jd0i0i/VORTICE/CAD/PLANOS/LAMINA1_alzado.png

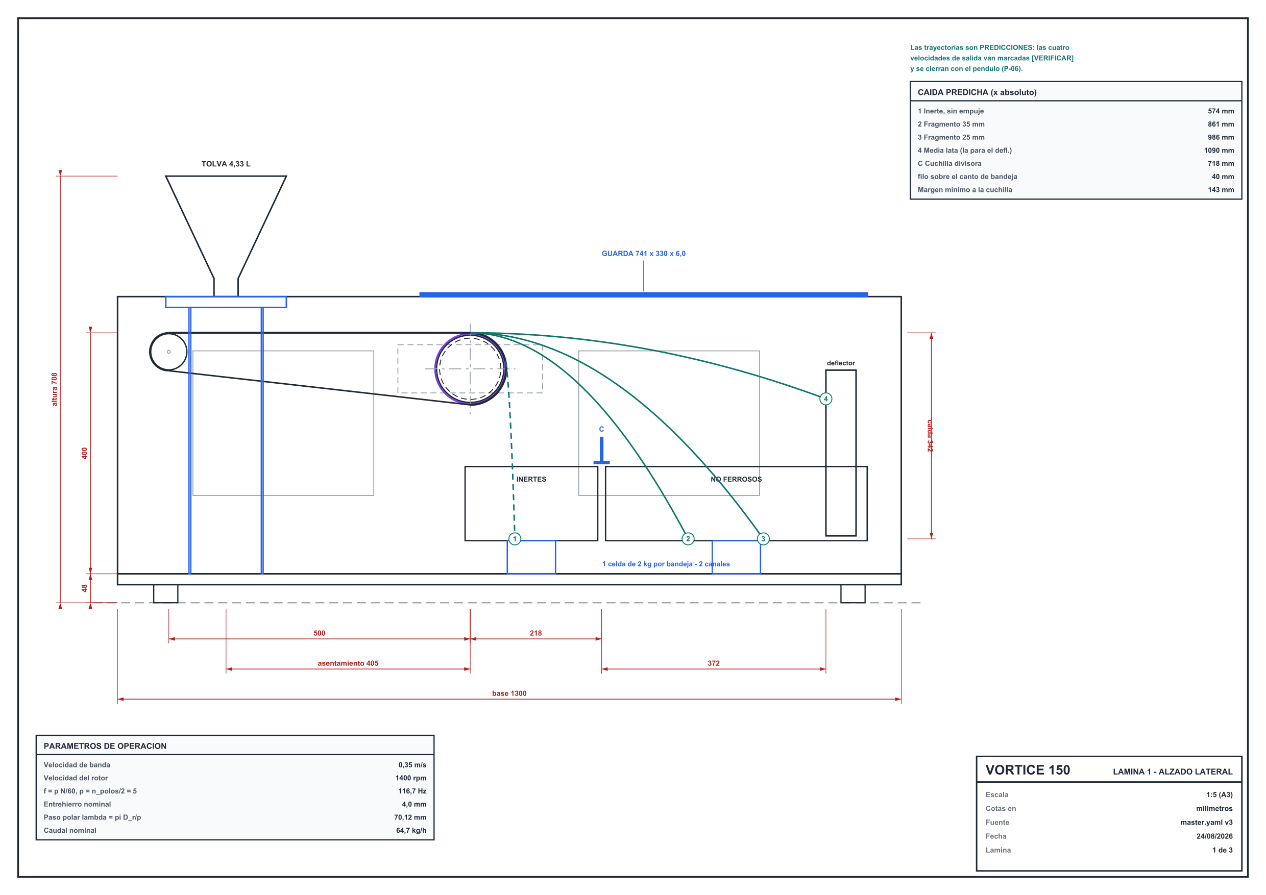
CAD/PLANOS/LAMINA1_alzado.png
