jd0i0i/VORTICE/CAD/PLANOS/LAMINA2_planta.png

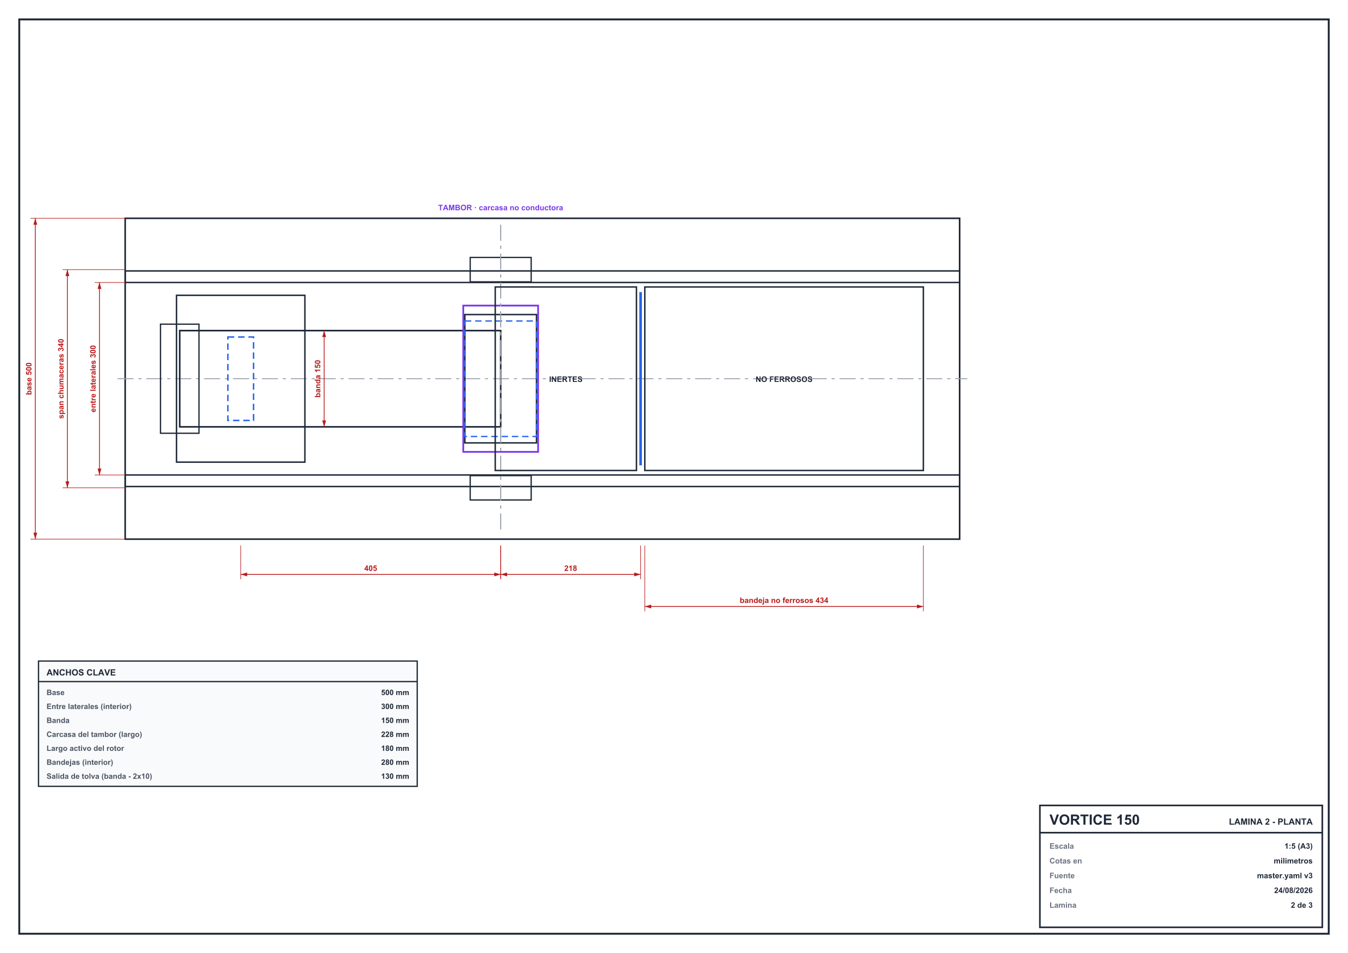
CAD/PLANOS/LAMINA2_planta.png
