jd0i0i/VORTICE/CAD/PLANOS/LAMINA3_rotor.png

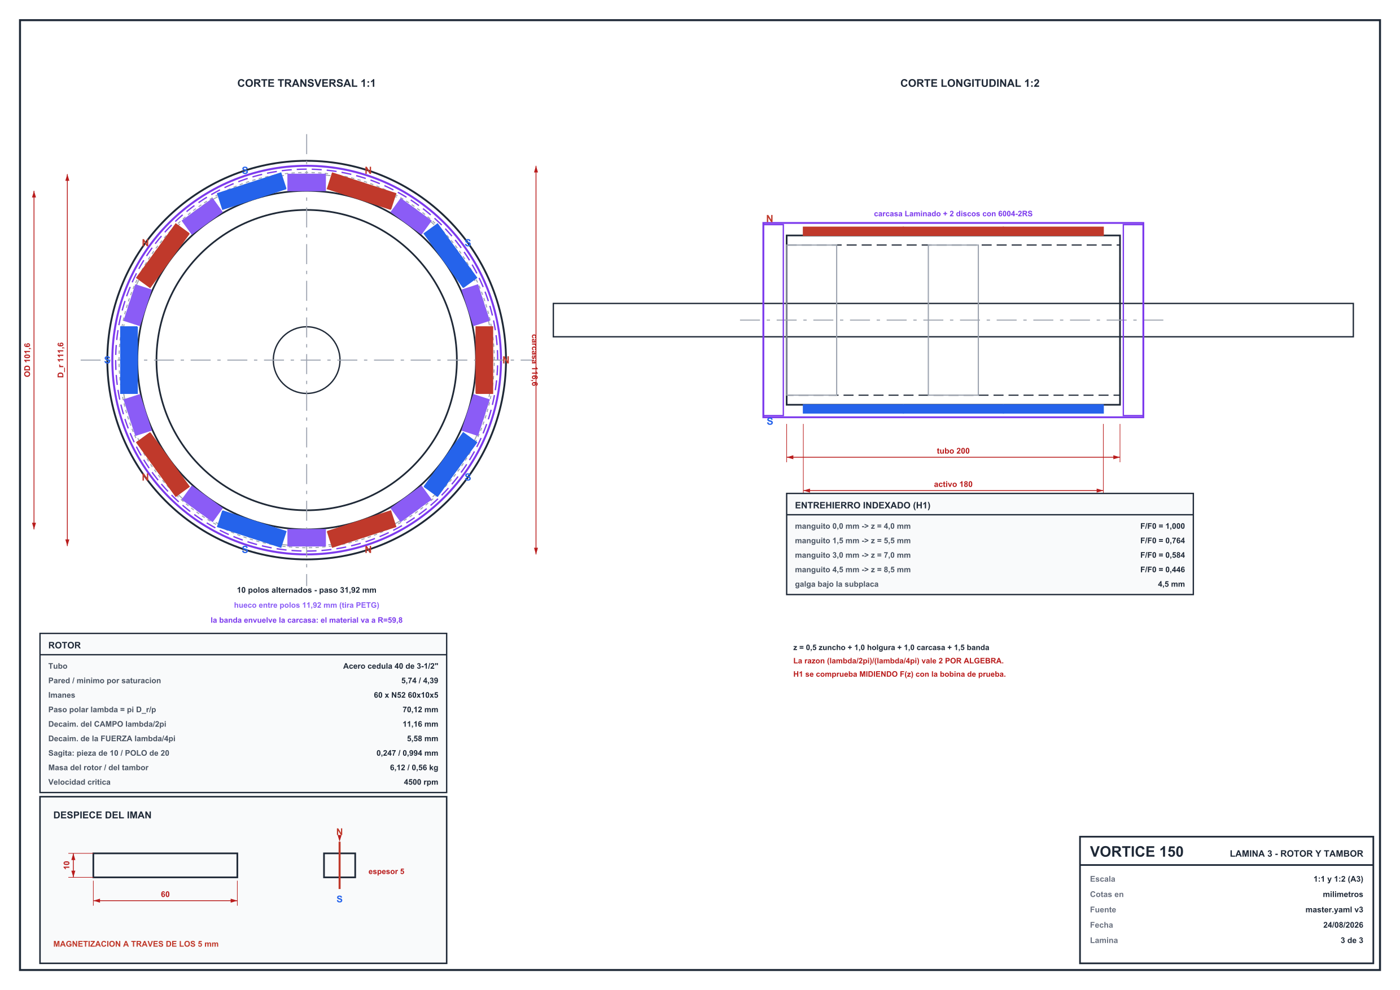
CAD/PLANOS/LAMINA3_rotor.png
