jd0i0i/VORTICE/CAD/PLANOS/Vista_isometrica.png

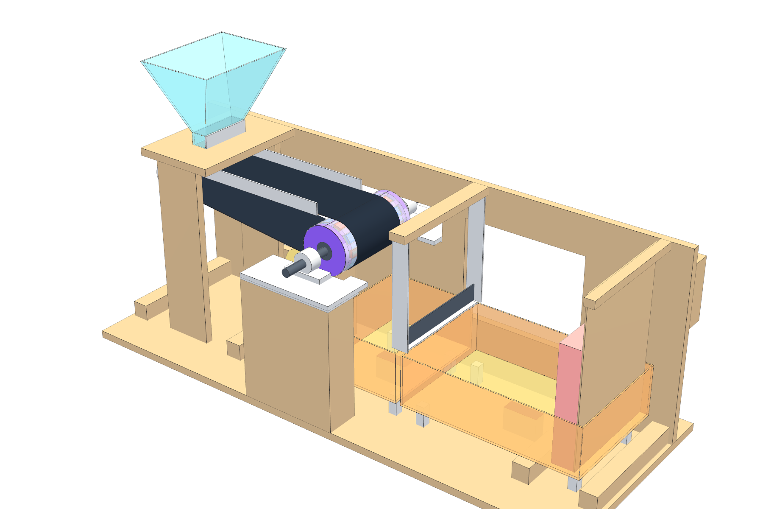
CAD/PLANOS/Vista_isometrica.png
