jd0i0i/VORTICE/CAD/PLANOS/Vista_lateral.png

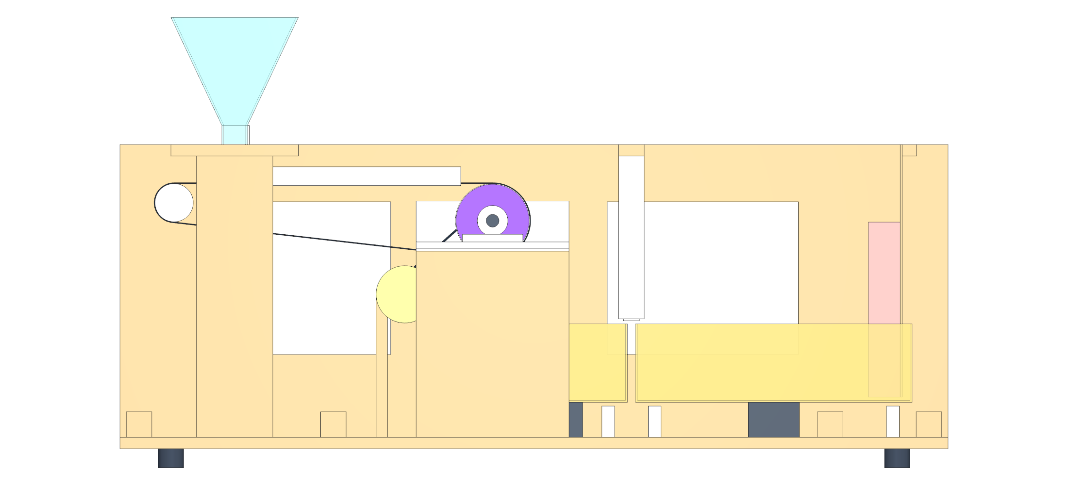
CAD/PLANOS/Vista_lateral.png
