jd0i0i/VORTICE/CAD/PLANOS/Vista_rotor_detalle.png

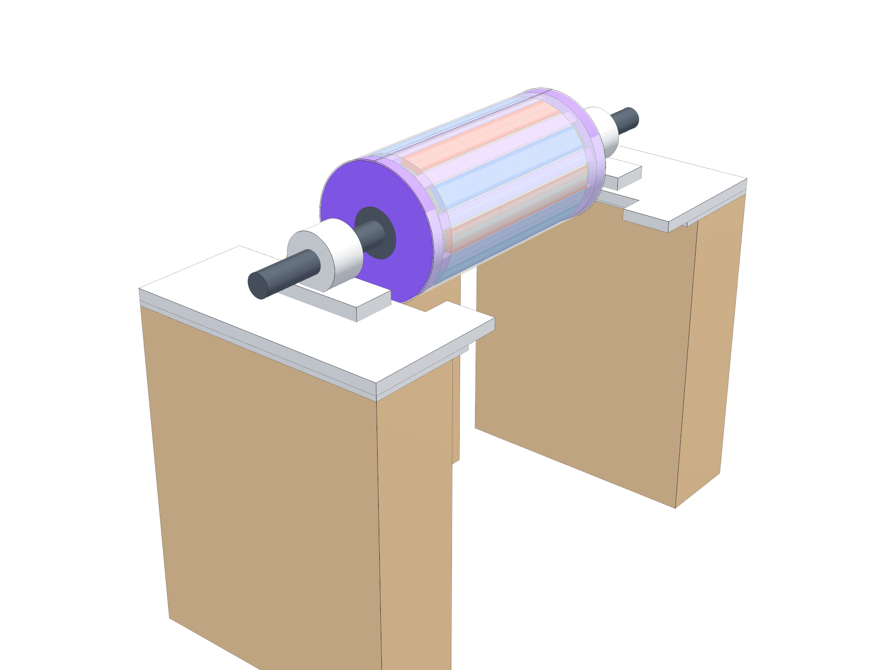
CAD/PLANOS/Vista_rotor_detalle.png
