jd0i0i/VORTICE/CAD/STEP/VORTICE_rotor.step

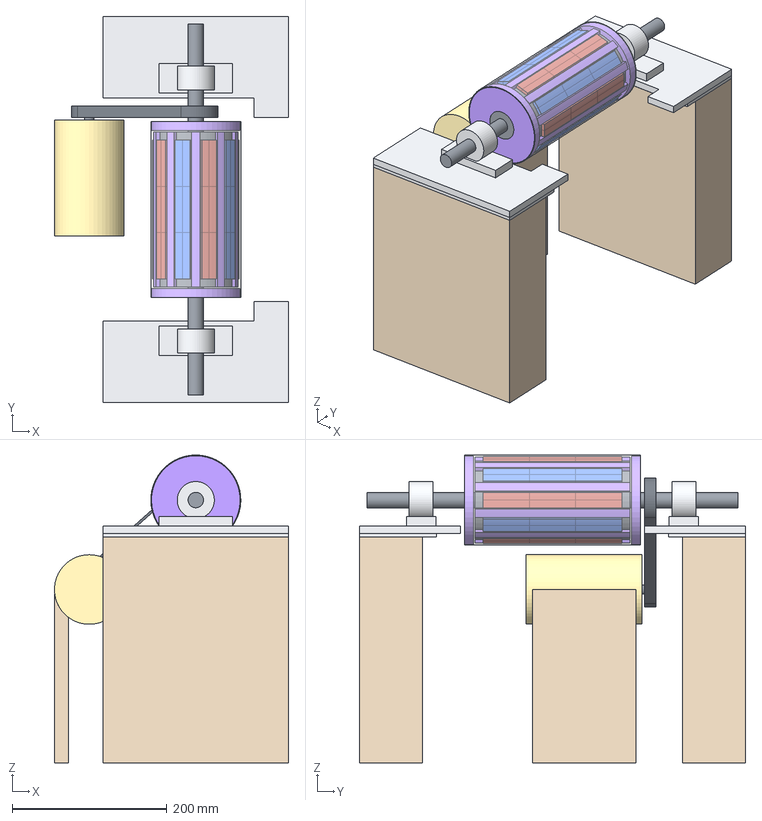
[picture p7: CAD file, 2026-08-25]
CAD/STEP/VORTICE_rotor.step
302.9 x 500.0 x 398.5 mm
rotor_tubo_022
iman_N_023
iman_N_024
iman_N_025
iman_N_026
iman_N_027
iman_N_028
iman_S_029
iman_S_030
iman_S_031
iman_S_032
iman_S_033
iman_S_034
iman_N_035
iman_N_036
iman_N_037
iman_N_038
iman_N_039
iman_N_040
iman_S_041
iman_S_042
iman_S_043
iman_S_044
iman_S_045
iman_S_046
iman_N_047
iman_N_048
iman_N_049
iman_N_050
iman_N_051
iman_N_052
iman_S_053
iman_S_054
iman_S_055
iman_S_056
iman_S_057
iman_S_058
iman_N_059
iman_N_060
iman_N_061
iman_N_062
iman_N_063
iman_N_064
iman_S_065
iman_S_066
iman_S_067
iman_S_068
iman_S_069
iman_S_070
iman_N_071
iman_N_072
iman_N_073
iman_N_074
iman_N_075
iman_N_076
iman_S_077
iman_S_078
iman_S_079
iman_S_080
iman_S_081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
