jd0i0i/VORTICE/CAD/STEP/VORTICE_guarda.step

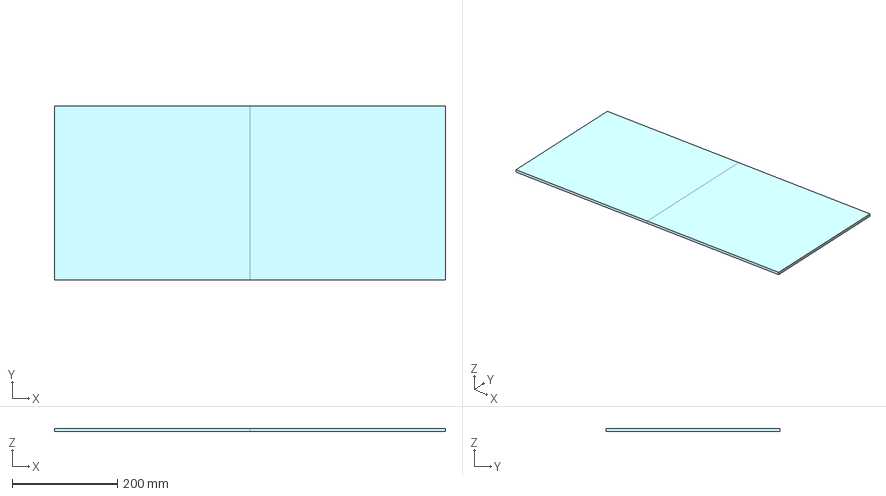
[picture p8: CAD file, 2026-08-25]
CAD/STEP/VORTICE_guarda.step
741.3 x 330.0 x 6.00 mm
guarda_policarbonato_137
guarda_policarbonato_138
