jd0i0i/VORTICE/CAD/STEP/VORTICE_maquina.step

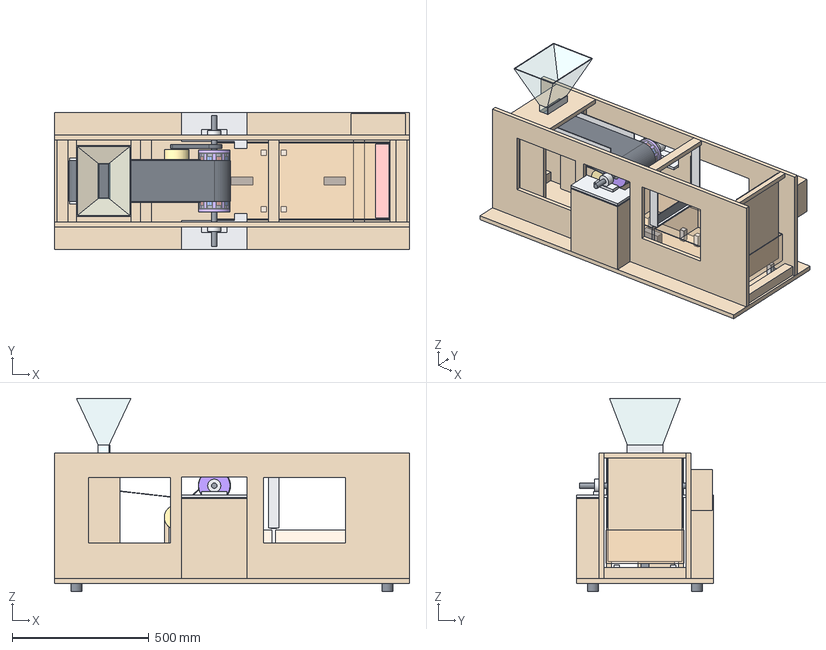
[picture p9: CAD file, 2026-08-25]
CAD/STEP/VORTICE_maquina.step
1300.0 x 500.0 x 708.0 mm
pata_000
pata_001
pata_002
pata_003
base_MDF_004
lateral_MDF_005
lateral_MDF_006
travesano_007
travesano_008
travesano_009
travesano_010
caja_control_011
rodillo_cola_012
banda_PVC_013
cama_deslizamiento_014
guia_lateral_015
guia_lateral_016
tolva_017
tolva_brida_018
tolva_soporte_019
tolva_soporte_020
compuerta_021
rotor_tubo_022
iman_N_023
iman_N_024
iman_N_025
iman_N_026
iman_N_027
iman_N_028
iman_S_029
iman_S_030
iman_S_031
iman_S_032
iman_S_033
iman_S_034
iman_N_035
iman_N_036
iman_N_037
iman_N_038
iman_N_039
iman_N_040
iman_S_041
iman_S_042
iman_S_043
iman_S_044
iman_S_045
iman_S_046
iman_N_047
iman_N_048
iman_N_049
iman_N_050
iman_N_051
iman_N_052
iman_S_053
iman_S_054
iman_S_055
iman_S_056
iman_S_057
iman_S_058
iman_N_059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
