jd0i0i/VORTICE/CAD/_legacy/VORTICE_maquina.step

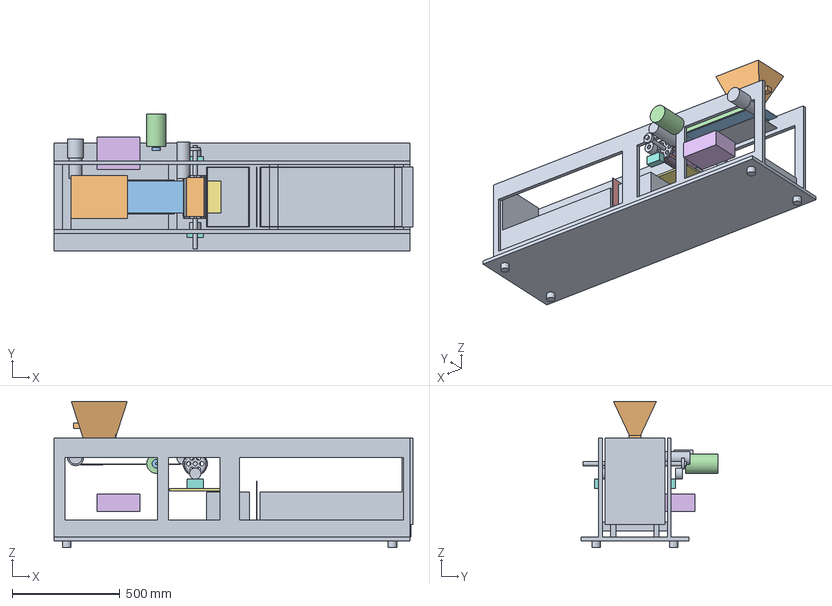
[picture p10: CAD file, 2026-08-25, an earlier design]
CAD/_legacy/VORTICE_maquina.step
1665.0 x 635.0 x 678.0 mm
