jd0i0i/VORTICE/CAD/_legacy/VORTICE_rotor.step

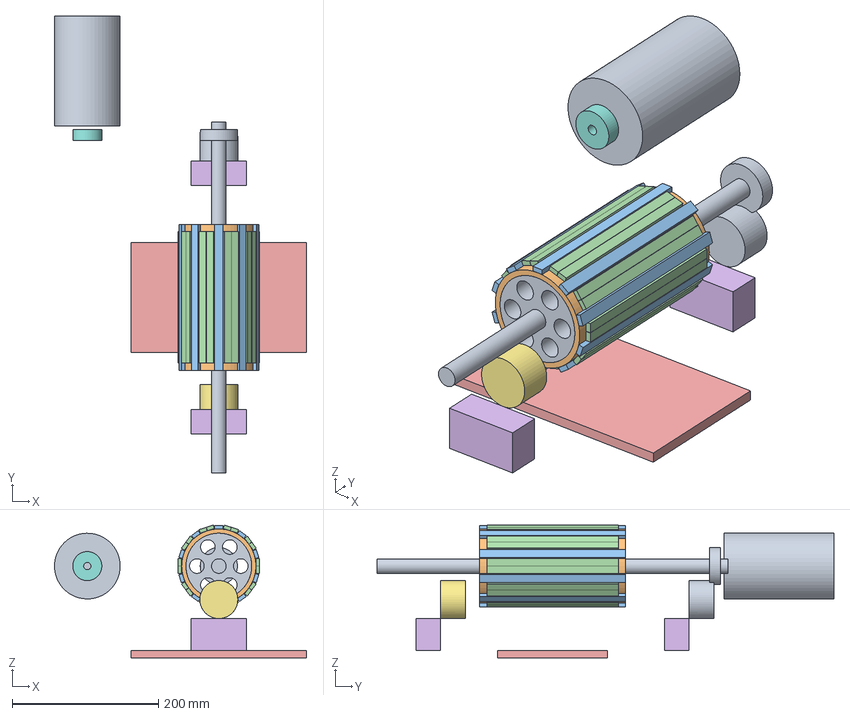
[picture p11: CAD file, 2026-08-25, an earlier design]
CAD/_legacy/VORTICE_rotor.step
344.9 x 625.0 x 182.0 mm
