jd0i0i/VORTICE/(list of files, cad)

Other CAD files:
CAD/STL/VORTICE_guarda.stl
CAD/STL/VORTICE_maquina.stl
CAD/STL/VORTICE_rotor.stl
